citizen4505/BuckBench-CC20/tools/README.md

# Nástroje

`schgen/` generuje KiCad schéma ze skriptu:

```
cd tools/schgen
python3 build.py                      # zapíše ../../hardware/buckbench-cc20.kicad_sch
kicad-cli sch export netlist -o /tmp/buckbench-cc20.net ../../hardware/buckbench-cc20.kicad_sch
kicad-cli sch export pdf -o ../../hardware/buckbench-cc20.pdf ../../hardware/buckbench-cc20.kicad_sch
```

`verify.py` porovná zamýšlené spoje (`netpins.json`, který vytvoří `build.py`) s netlistem z KiCadu.

Schéma můžeš upravovat i přímo v KiCadu – pak už ale generátor nepouštěj, přepsal by ruční změny.
