citizen4505/BuckBench-CC20/hardware/buckbench-cc20.kicad_sch

## KiCad design hardware/buckbench-cc20.kicad_sch (2026-10-27)

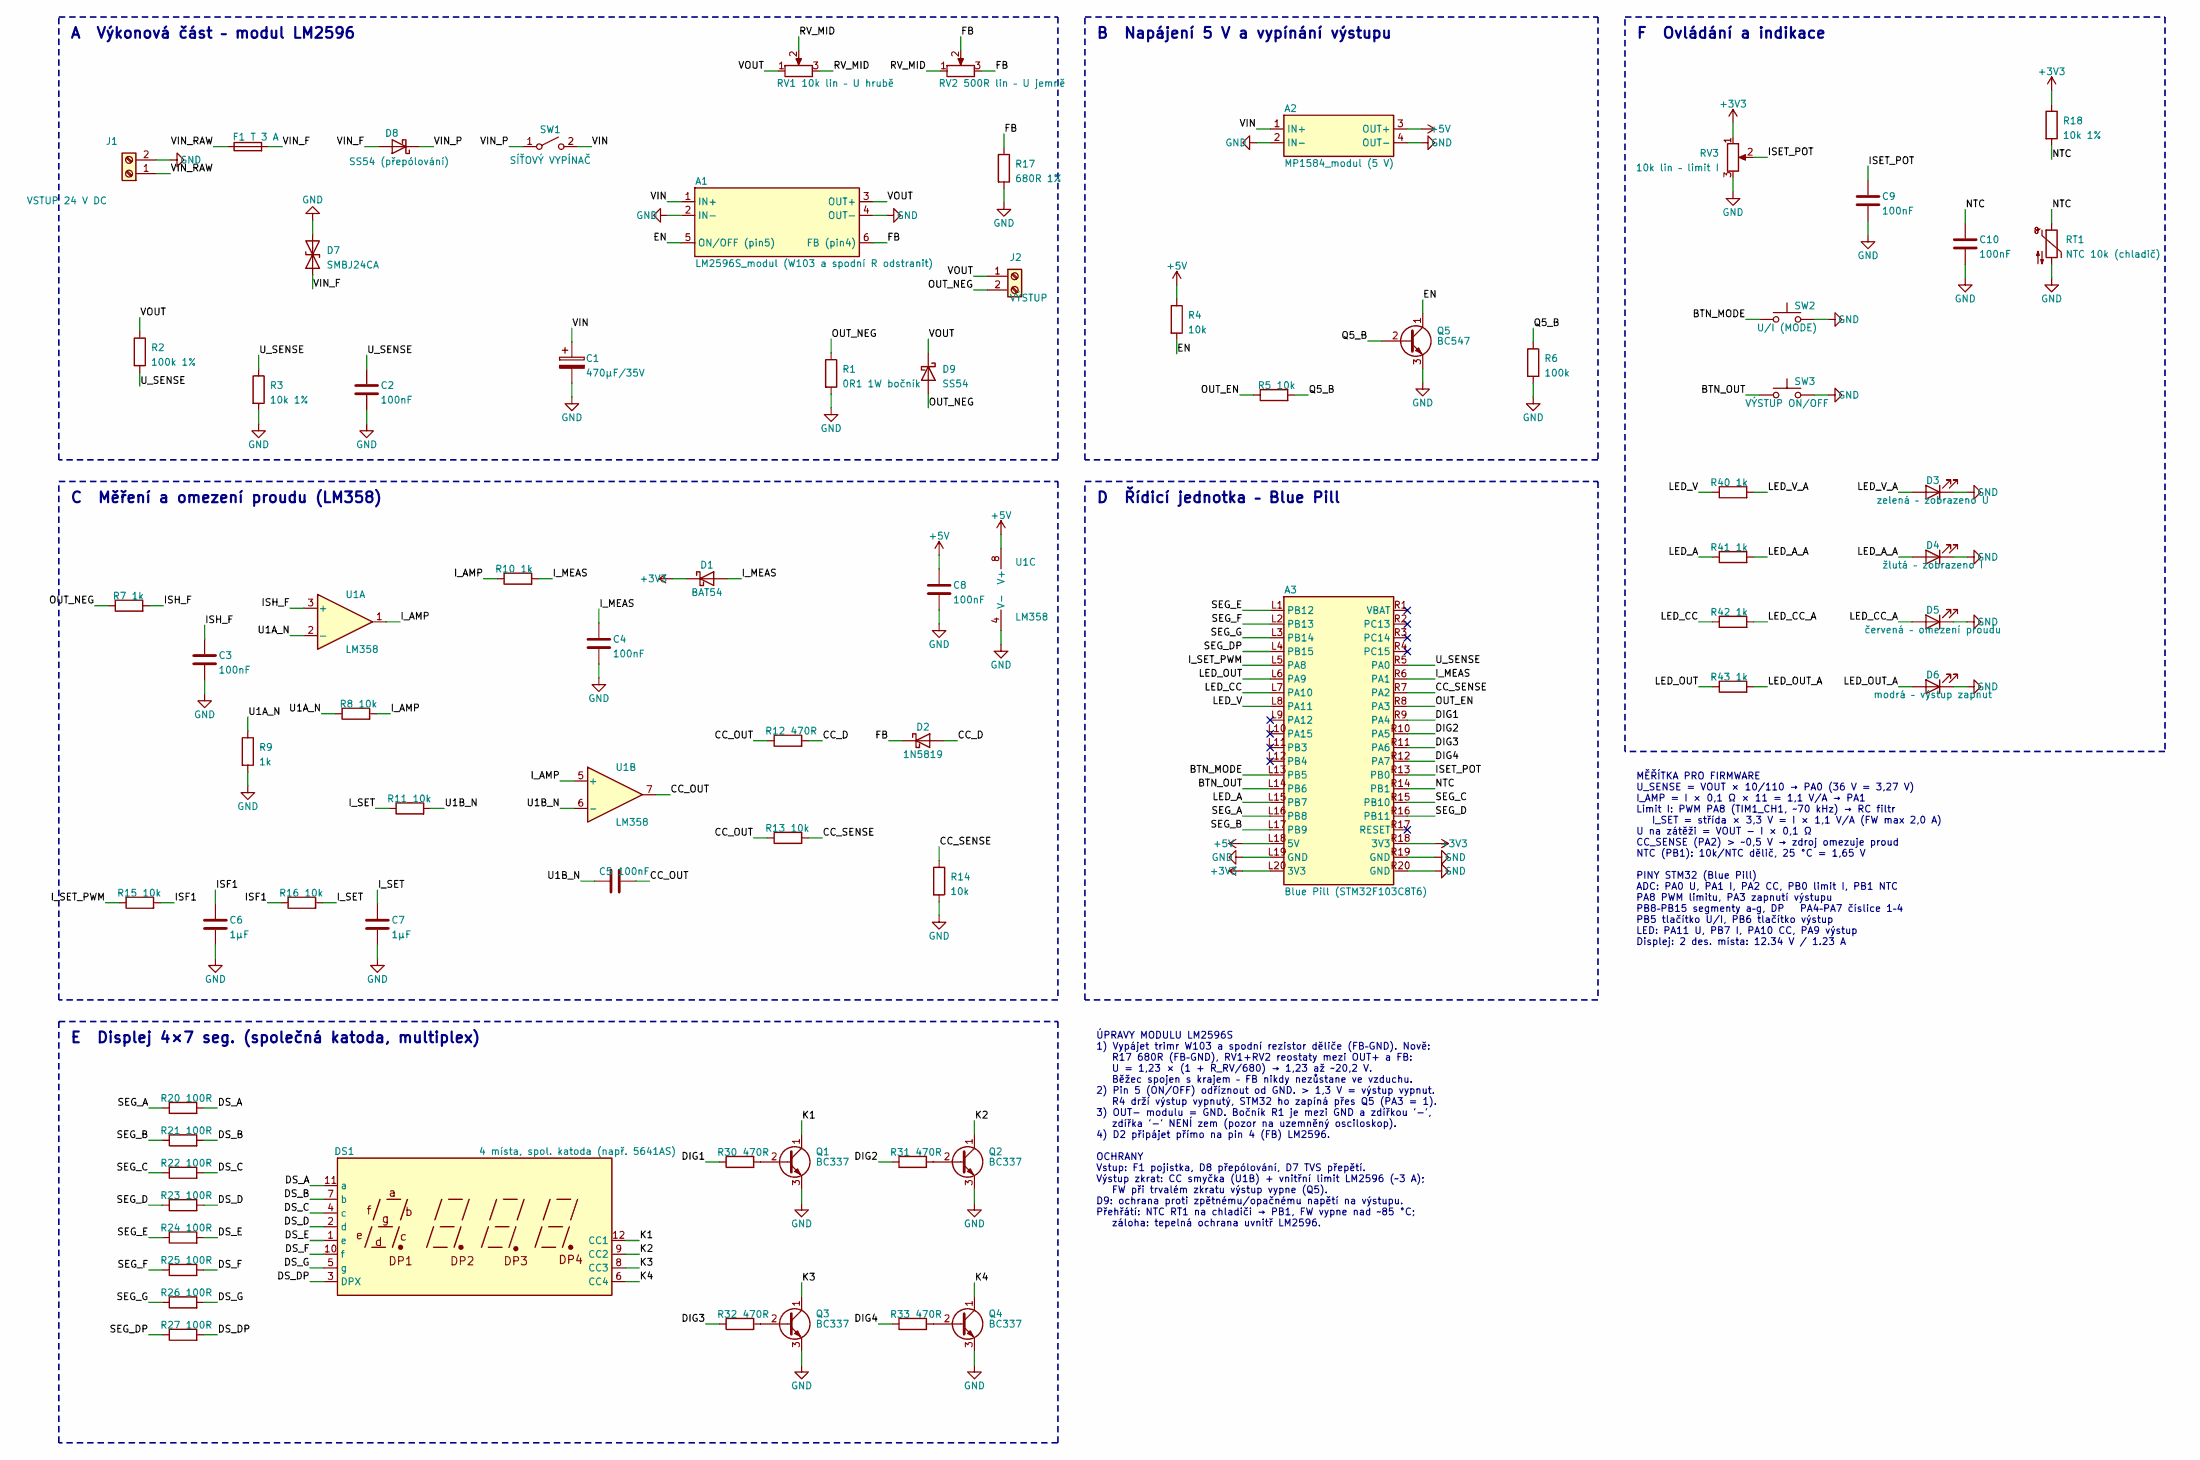
[picture p1: schematic buckbench-cc20.kicad_sch]

Parts:
A1: LM2596S_modul (W103 a spodní R odstranit)
A2: MP1584_modul (5 V)
A3: Blue Pill (STM32F103C8T6)
C1: 470µF/35V
C2, C3, C4, C5, C8, C9, C10: 100nF
C6, C7: 1µF
D1: BAT54
D2: 1N5819
D3: zelená – zobrazeno U
D4: žlutá – zobrazeno I
D5: červená – omezení proudu
D6: modrá – výstup zapnut
D7: SMBJ24CA
D8: SS54 (přepólování)
D9: SS54
DS1: 4 místa, spol. katoda (např. 5641AS); CA56-12EWA
F1: T 3 A
J1: VSTUP 24 V DC
J2: VÝSTUP
Q1, Q2, Q3, Q4: BC337; TO-92_Inline
Q5: BC547; TO-92_Inline
R1: 0R1 1W bočník
R2: 100k 1%
R3, R18: 10k 1%
R4, R5, R8, R11, R13, R14, R15, R16: 10k
R6: 100k
R7, R9, R10, R40, R41, R42, R43: 1k
R12, R30, R31, R32, R33: 470R
R17: 680R 1%
R20, R21, R22, R23, R24, R25, R26, R27: 100R
RT1: NTC 10k (chladič)
RV1: 10k lin – U hrubě
RV2: 500R lin – U jemně
RV3: 10k lin – limit I
SW1: SÍŤOVÝ VYPÍNAČ
SW2: U/I (MODE)
SW3: VÝSTUP ON/OFF
U1: LM358

Connections:
+3V3: A3.L20 (3V3), A3.R18 (3V3), D1.1 (K), R18.1, RV3.1
+5V: A2.3 (OUT+), A3.L18 (5V), C8.1, R4.1, U1.8 (V+)
BTN_MODE: A3.L13 (PB5), SW2.1
BTN_OUT: A3.L14 (PB6), SW3.1
CC_D: D2.2 (A), R12.2
CC_OUT: C5.2, R12.1, R13.1, U1.7
CC_SENSE: A3.R7 (PA2), R13.2, R14.1
DIG1: A3.R9 (PA4), R30.1
DIG2: A3.R10 (PA5), R31.1
DIG3: A3.R11 (PA6), R32.1
DIG4: A3.R12 (PA7), R33.1
DS_A: DS1.11 (a), R20.2
DS_B: DS1.7 (b), R21.2
DS_C: DS1.4 (c), R22.2
DS_D: DS1.2 (d), R23.2
DS_DP: DS1.3 (DPX), R27.2
DS_E: DS1.1 (e), R24.2
DS_F: DS1.10 (f), R25.2
DS_G: DS1.5 (g), R26.2
EN: A1.5 (ON/OFF (pin5)), Q5.1 (C), R4.2
FB: A1.6 (FB (pin4)), D2.1 (K), R17.1, RV2.2, RV2.3
GND: A1.2 (IN-), A1.4 (OUT-), A2.2 (IN-), A2.4 (OUT-), A3.L19 (GND), A3.R19 (GND), A3.R20 (GND), C1.2, C2.2, C3.2, C4.2, C6.2, C7.2, C8.2, C9.2, C10.2, D3.1 (K), D4.1 (K), D5.1 (K), D6.1 (K), D7.2 (A2), J1.2, Q1.3 (E), Q2.3 (E), Q3.3 (E), Q4.3 (E), Q5.3 (E), R1.2, R3.2, R6.2, R9.2, R14.2, R17.2, RT1.2, RV3.3, SW2.2, SW3.2, U1.4 (V-)
ISET_POT: A3.R13 (PB0), C9.1, RV3.2
ISF1: C6.1, R15.2, R16.1
ISH_F: C3.1, R7.2, U1.3 (+)
I_AMP: R8.2, R10.1, U1.1, U1.5 (+)
I_MEAS: A3.R6 (PA1), C4.1, D1.2 (A), R10.2
I_SET: C7.1, R11.1, R16.2
I_SET_PWM: A3.L5 (PA8), R15.1
K1: DS1.12 (CC1), Q1.1 (C)
K2: DS1.9 (CC2), Q2.1 (C)
K3: DS1.8 (CC3), Q3.1 (C)
K4: DS1.6 (CC4), Q4.1 (C)
LED_A: A3.L15 (PB7), R41.1
LED_A_A: D4.2 (A), R41.2
LED_CC: A3.L7 (PA10), R42.1
LED_CC_A: D5.2 (A), R42.2
LED_OUT: A3.L6 (PA9), R43.1
LED_OUT_A: D6.2 (A), R43.2
LED_V: A3.L8 (PA11), R40.1
LED_V_A: D3.2 (A), R40.2
NTC: A3.R14 (PB1), C10.1, R18.2, RT1.1
unnamed: Q1.2 (B), R30.2
unnamed: Q2.2 (B), R31.2
unnamed: Q3.2 (B), R32.2
unnamed: Q4.2 (B), R33.2
OUT_EN: A3.R8 (PA3), R5.1
OUT_NEG: D9.2 (A), J2.2, R1.1, R7.1
Q5_B: Q5.2 (B), R5.2, R6.1
RV_MID: RV1.2, RV1.3, RV2.1
SEG_A: A3.L16 (PB8), R20.1
SEG_B: A3.L17 (PB9), R21.1
SEG_C: A3.R15 (PB10), R22.1
SEG_D: A3.R16 (PB11), R23.1
SEG_DP: A3.L4 (PB15), R27.1
SEG_E: A3.L1 (PB12), R24.1
SEG_F: A3.L2 (PB13), R25.1
SEG_G: A3.L3 (PB14), R26.1
U1A_N: R8.1, R9.1, U1.2 (-)
U1B_N: C5.1, R11.2, U1.6 (-)
U_SENSE: A3.R5 (PA0), C2.1, R2.2, R3.1
VIN: A1.1 (IN+), A2.1 (IN+), C1.1, SW1.2 (B)
VIN_F: D7.1 (A1), D8.2 (A), F1.2
VIN_P: D8.1 (K), SW1.1 (A)
VIN_RAW: F1.1, J1.1
VOUT: A1.3 (OUT+), D9.1 (K), J2.1, R2.1, RV1.1

Notes on the sheet:
A Výkonová část – modul LM2596
B Napájení 5 V a vypínání výstupu
C Měření a omezení proudu (LM358)
D Řídicí jednotka – Blue Pill
E Displej 4×7 seg. (společná katoda, multiplex)
F Ovládání a indikace
ÚPRAVY MODULU LM2596S 1) Vypájet trimr W103 a spodní rezistor děliče (FB–GND). Nově: R17 680R (FB–GND), RV1+RV2 reostaty mezi OUT+ a FB: U = 1,23 × (1 + R_RV/680) → 1,23 až ~20,2 V. Běžec spojen s krajem – FB nikdy nezůstane ve vzduchu. 2) Pin 5 (ON/OFF) odříznout od GND. > 1,3 V = výstup vypnut. R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
MĚŘÍTKA PRO FIRMWARE U_SENSE = VOUT × 10/110 → PA0 (36 V = 3,27 V) I_AMP = I × 0,1 Ω × 11 = 1,1 V/A → PA1 Limit I: PWM PA8 (TIM1_CH1, ~70 kHz) → RC filtr I_SET = střída × 3,3 V = I × 1,1 V/A (FW max 2,0 A) U na zátěži = VOUT − I × 0,1 Ω CC_SENSE (PA2) > ~0,5 V → zdroj omezuje proud NTC (PB1): 10k/N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
