citizen4505/BuckBench-CC20/(commit log)

2026-10-27 Schéma zapojení rev. 1, dokumentace, generátor schématu
    [bom.csv, buckbench.kicad_sch]
2026-10-27 Přejmenování projektu na Buckbench-CC20
    Claude-Session: https://claude.ai/code/session_01Ssrj2kgLuwDYsWDSUoWqnJ
    [buckbench-cc20.kicad_sch]
